almunajib/mcu-vm/Top-Layer_MCU4.5.jpg

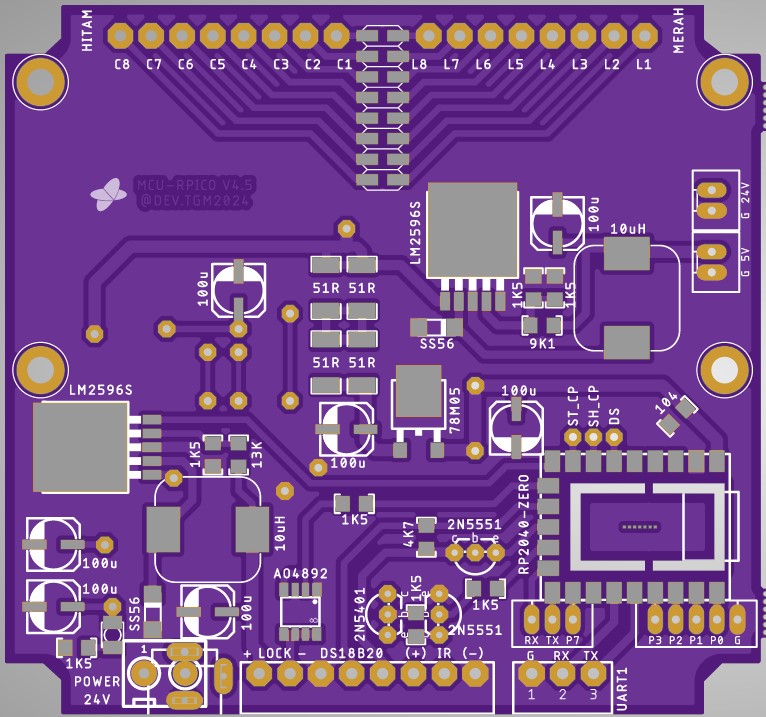
Top-Layer_MCU4.5.jpg
