almunajib/mcu-vm/SS-SerialSender.png

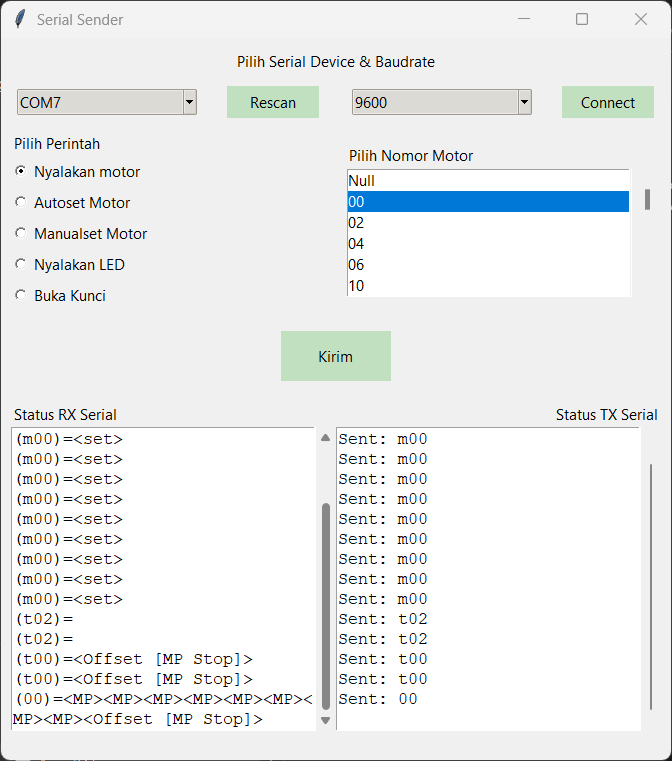
SS-SerialSender.png
