almunajib/mcu-vm/Daftar-komponen_MCU4.5-combined.xlsx

Qty | Value | Device | Parts | Harga | Total | STOK BARANG | LINK
1 |  | JACK-DC_5.5X2.5MM MALE | J3 | Rp 1200 | Rp 1200 | READY | https://www.tokopedia.com/rajacell/dc-005-socket-female-jack-dc-power-jack-5-5mm-x-2-1mm-3p-tanampcb-hitam
1 |  | JACK-DC_5.5X2.5MM FEMALE |  | Rp 1700 |  | READY | https://www.tokopedia.com/rajacell/jack-dc-5-5mm-x-2-1mm-yellow-head-dengan-kabel-20cm-kabel-merah
64 |  | LED2835 | B1, B2, B3, B4, B5, B6, B7, B8, B9, B10, B11, B12, B13, B14, B15, B16, B17, B18, B19, B20, B21, B22, B23, B24, B25, B26, B27, B28, B29, B30, B31, B32, B33, B34, B35, B36, B37, B38, B39, B40, B41, B42, B43, B44, B45, B46, B47, B48, B49, B50, B51, B52, B53, B54, B55, B56, B57, B58, B59, B60, B61, B62, B63, B64 | Rp 100 | Rp 6400 | READY MIN.ORDER 50 PCS | https://www.tokopedia.com/mirorim/smd-led-chip-2835-0-2w-cool-cold-warm-white-putih-kuning-lampu-strip-warm-white
1 | POWER | LED2835 | D2 | Rp 100 | Rp 100 | READY | https://www.tokopedia.com/mirorim/smd-led-chip-2835-0-2w-cool-cold-warm-white-putih-kuning-lampu-strip-warm-white
1 |  | PINHEAD_2X8PTH | J4 | Rp 3250 | Rp 3250 | READY | https://www.tokopedia.com/rajacell/double-row-female-header-2x40-pin-socket-female-pitch-254mm-double
1 |  | PINHEAD_2X8SMT | J5 | Rp 5500 | Rp 5500 | READY | https://www.tokopedia.com/rajacell/2x40p-smd-male-header-smt-pitch-2-54mm-double-row-straight-male-gold-plated-2-40-80-pin
2 |  | SOKET-2P_JST-XH-2.54 | X7, X8 | Rp 350 | Rp 700 | READY | https://www.tokopedia.com/easyware-id/set-jst-xh-connector-2p-lurus-header-2-pin-male-female-xh-2-54mm-female-d0c8c
1 |  | SOKET-3P_JST-XH-2.54 | J1 | Rp 400 | Rp 400 | READY | https://www.tokopedia.com/easyware-id/connector-jst-xh2-54-3p-male-straight-header-2-54mm-ci22-3-pin-female-female
1 |  | SOKET-5P_JST-XH-2.54 | X3 | Rp 500 | Rp 500 | READY | https://www.tokopedia.com/easyware-id/connector-jst-xh2-54-5p-male-straight-header-2-54mm-ci22-5-pin-female-female
12 |  |  |  | Rp 110 | Rp 1320 | READY MIN.ORDER 10 PCS | https://www.tokopedia.com/easyware-id/jst-xh2-50mm-ci22-inner-2-50-mm-female-wire-housing-pin-metal-terminal
1 |  | TBLOCK-2P_5.08MM | XDC | Rp 2250 | Rp 2250 | KOSONG | https://www.tokopedia.com/marnov/15edgk-r-3-81-2p-screw-siku-15edgk-terminal-3-81mm-mm-2-pin-2edg
1 |  | TBLOCK-3P_KF2EDG-3.81 | J6 | Rp 2750 | Rp 2750 |  | https://www.tokopedia.com/marnov/15edgk-r-3-81-3p-screw-siku-15edgk-terminal-3-81mm-mm-3-pin-2edg
1 |  | TBLOCK-8P_KF2EDG-3.81 | X1 | Rp 7000 | Rp 7000 |  | https://www.tokopedia.com/marnov/15edgk-r-3-81-8p-screw-siku-15edgk-terminal-3-81mm-mm-8-pin-2edg
7 | 100u | ELCO_UD-6,3X7,7 | C1, C3, C4, C5, C6, C7, C11 | Rp 800 | Rp 5600 |  | https://www.tokopedia.com/jogjarobotika/25v-100uf-smd-elco-6-7mm
4 | 104 | CAP_SMD-C1206 | C8, C9, C10, C14 | Rp 250 | Rp 1000 | READY MIN.ORDER 25 PCS | https://www.tokopedia.com/lisuinstrument/100nf-10-50v-x7r-1206-3216-mm-smd-ceramic-capacitor-fn31x104k500pxg
24 | 10K | RESISTOR_1206 | R6, R7, R8, R10, R11, R13, R14, R15, R17, R20, R21, R22, R25, R26, R27, R30, R31, R32, R35, R36, R37, R38, R41, R42 | Rp 100 | Rp 2400 | READY | https://www.tokopedia.com/jogjarobotika/10k-ohm-smd-1206-resistor
2 | 10uH | INDUKTORSMD | L1, L2 | Rp 1000 | Rp 2000 | READY | https://www.tokopedia.com/tokopuwei/power-inductor-10uh-smd-5a-cd127-smt-induktor-12-x-12-x-7mm-ak00
1 | 13K | RESISTOR_1206 | R2 | Rp 100 | Rp 100 | READY MIN.ORDER 25 PCS | https://www.tokopedia.com/lisuinstrument/13k-1206-3216-mm-1-thick-film-smd-resistor-250mw-13k
10 | 1K5 | RESISTOR_1206 | R4, R5, R12, R18, R28, R39, R45, R46, R47, R49 | Rp 100 | Rp 1000 | READY MIN.ORDER 10 PCS | https://www.tokopedia.com/lisuinstrument/1-5k-1206-1-thick-film-resistors-smd-chip-resistor-1501-1k5
1 | 2N5401 | BJT-PNP_TO92-EBC | Q10 | Rp 150 | Rp 150 | READY | https://www.tokopedia.com/lisuinstrument/2n5401-pnp-bipolar-transistor-bjt-to-92-generic-biasa-88350
2 | 2N5551 | BJT-NPN_TO92-EBC | TR10, TR12 | Rp 150 | Rp 300 | READY | https://www.tokopedia.com/lisuinstrument/2n5551-npn-bipolar-transistor-bjt-to-92-generic-biasa-a4086
8 | 2x1K5 GANTI 470 | RESISTOR_1206 | R3, R16, R19, R23, R24, R29, R33, R34 | Rp 250 | Rp 2000 | READY MIN.ORDER 10 PCS | https://www.tokopedia.com/lisuinstrument/470r-1210-3225-metric-1-thick-film-resistor-smd-470-0-5w
1 | 4K7 | RESISTOR_1206 | R9 | Rp 250 | Rp 250 | READY MIN.ORDER 10 PCS | https://www.tokopedia.com/lisuinstrument/4-7k-1210-3225-1-thick-film-resistor-smd-4-7k-100ppm-c-0-5w
6 | 51R | RESISTOR_2512 | R1, R40, R44, R48, R50, R51 | Rp 500 | Rp 3000 | READY MIN.ORDER 11 PCS | https://www.tokopedia.com/lisuinstrument/51r-2512-5-1w-thick-film-resistor-smd-chip-resistor-510-51r
2 | 74595 | 74595 | IC1, IC2 | Rp 620 | Rp 1240 | READY | https://www.tokopedia.com/tokopuwei/ic-74hc595-74hc595d-smd-sop-16-shift-register-chip-au08
1 | 78M05 | 78XXX_TO252 | IC4 | Rp 600 | Rp 600 | READY | https://www.tokopedia.com/tokopuwei/smd-7805-regulator-78m05-5v-smd-regulator-to252-dpack-d-pack-af73
1 | 9K1 | RESISTOR_1206 | R43 | Rp 100 | Rp 100 | READY | https://www.tokopedia.com/jogjarobotika/9k1-ohm-smd-1206-resistor
1 | AMS1117 | 78XXX_SOT223 | VREG2 | Rp 700 | Rp 700 | READY | https://www.tokopedia.com/tokopuwei/ams1117-33v-33v-1a-smd-voltage-regulator-sot223-3v3-sot-223-ah33
5 | AO4892 | DUALFET-N_AO4892N+N | Q5, Q6, Q7, Q8, Q9 | Rp 9500 | Rp 47500 | READY | https://www.tokopedia.com/lisuinstrument/ao4892-4892-100v-4a-dual-n-channel-mosfet-alpha-omega-original
4 | APM4953 | DUALFET-P_NCE4953P+P | Q1, Q2, Q3, Q4 | Rp 2500 | Rp 10000 | READY | https://www.tokopedia.com/jogjarobotika/4953-apm4953-sop8-dual-p-channel-mosfet
1 | HITAM | TBLOCK-8P_KF2EDG-3.81 | J8 | Rp 7000 | Rp 7000 | READY | https://www.tokopedia.com/marnov/15edgk-r-3-81-8p-screw-siku-15edgk-terminal-3-81mm-mm-8-pin-2edg
2 | LM2596S | LM2596S | IC5, IC6 | Rp 4500 | Rp 9000 | READY | https://www.tokopedia.com/permony/ic-lm2596hvs-3a-adjustable-lm2596-lm2596s
1 | MERAH | TBLOCK-8P_KF2EDG-3.81 | J2 | Rp 7000 | Rp 7000 | READY | https://www.tokopedia.com/marnov/15edgk-r-3-81-8p-screw-siku-15edgk-terminal-3-81mm-mm-8-pin-2edg
1 | RP2040-ZERO | RASPBERRY-PICO-ZERO-SMT_TYPE-C | U2 | Rp 60000 | Rp 60000 | READY | https://www.tokopedia.com/hobielektronika/raspberry-pi-pico-rp2040-zero-mikrocontroller-dual-core-cortex-m0
2 | SS56 GANTI SS36A | DIODE_DO214AC | D3, D5 | Rp 800 | Rp 1600 | READY MIN.ORDER 5 PCS | https://www.tokopedia.com/lisuinstrument/ss36a-60v-3a-schottky-diode-sma-do-214ac-ss36-hottech-original
1 | SS56C GANTI SS510 | DIODE_DO214AB-SMC | D1 | Rp 1600 | Rp 1600 | READY MIN.ORDER 6 PCS | https://www.tokopedia.com/lisuinstrument/ss510c-5a-100v-schottky-barrier-diode-ss510-do-214ab-smc-jingdao
1 | ULN2803 | ULN2805ASO18 | IC3 | Rp 2750 | Rp 2750 | READY | https://www.tokopedia.com/rajacell/ic-uln2803-uln2803ag-smd-sop-18-8channel-darlington-sink-driver
1 |  | Box PLC |  | Rp 25000 | Rp 25000 | READY | https://www.tokopedia.com/sinarled/box-plc-115-90-40
1 |  | rivet lubang 0.9 mm |  | Rp 15000 | Rp 15000 | READY | https://www.tokopedia.com/gresstudio/0-9x3mm-0-9mm-tubular-rivets-round-head-copper-brass-hollow-rivets
 |  |  |  |  | Rp 238260
