almunajib/mcu-vm/MAINBOARD VM-MCU v4.5/VM-MCU_v4.5.brd

## EAGLE design MAINBOARD VM-MCU v4.5/VM-MCU_v4.5.brd (2025-02-11)

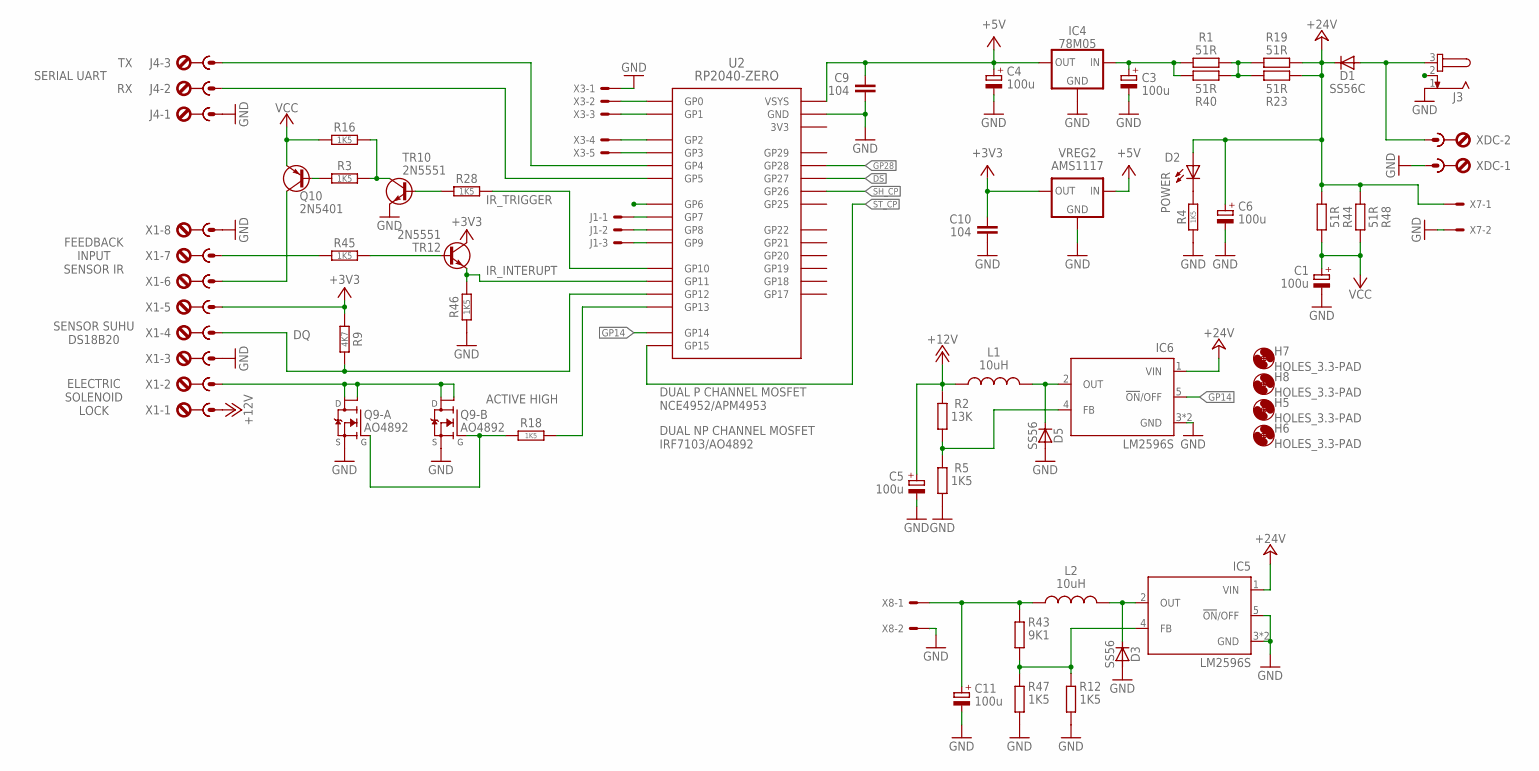
[picture p3: schematic VM-MCU_v4.5.sch, sheet 1]

Parts:
C1, C3, C4, C5, C6, C11: 100u; UD-6,3X7,7_NICHICON
C9, C10: 104; C1206
D1: SS56C; DO214AB
D2: POWER; LED2835
D3, D5: SS56; DO214AC
H5, H6, H7, H8: HOLES_3.3-PAD; 3,3-PAD
IC4: 78M05; TO252
IC5, IC6: LM2596S; TO263-5
J1: SOKET-3P_JST-XH-2.54; 3P-JST-XH
J3: JACK-DC_5.5X2.5MM; DC-5.5X2.5
J4: TBLOCK-3P_KF2EDG-3.81; KF2EDG-3.81_3P
L1, L2: 10uH; CDRH127/LD
Q9: AO4892; SO-8
Q10: 2N5401; TO92-EBC
R1, R19, R23, R40, R44, R48: 51R; R2512
R2: 13K; R1206
R3, R4, R5, R12, R16, R18, R28, R45, R46, R47: 1K5; R1206
R9: 4K7; R1206
R43: 9K1; R1206
TR10, TR12: 2N5551; TO92-EBC
U2: RP2040-ZERO; PICO-ZERO-SMT-C
VREG2: AMS1117; SOT223
X1: TBLOCK-8P_KF2EDG-3.81; KF2EDG-3.81_8P
X3: SOKET-5P_JST-XH-2.54; 5P-JST-XH
X7, X8: SOKET-2P_JST-XH-2.54; 2P-JST-XH
XDC: TBLOCK-2P_5.08MM; KF128-5_2P

Connections:
3V3: U2.3V3
+3V3: C10.1, R9.1, TR12.C, VREG2.4 (OUT), X1.5
+5V: C4.+, C9.1, IC4.2 (OUT), U2.5V (VSYS), VREG2.3 (IN); also elsewhere on the board
+12V: C5.+, L1.1, R2.1, X1.1
+24V: C6.+, D1.C, D2.A, IC5.1 (VIN), IC6.1 (VIN), R19.2, R23.1, R44.1, R48.1, X7.1; also elsewhere on the board
DS: U2.P27 (GP27); also elsewhere on the board
GND: C1.-, C3.-, C4.-, C5.-, C6.-, C9.2, C10.2, C11.-, D3.A, D5.A, IC4.3 (GND), IC5.3 (GND), IC5.5 (!ON!/OFF), IC5.6 (GND), IC6.3 (GND), IC6.6 (GND), J3.1, J4.1, Q9.1 (S), Q9.3 (S), R4.1, R5.2, R12.2, R46.1, R47.2, TR10.E, U2.G (GND), VREG2.1 (GND), X1.3, X1.8, X3.1, X7.2, X8.2, XDC.1; also elsewhere on the board
GP7: J1.1, U2.P7 (GP7)
GP8_TX: J1.2, U2.P8 (GP8)
GP9_RX: J1.3, U2.P9 (GP9)
GP12: R9.2, U2.P12 (GP12), X1.4
GP14: IC6.5 (!ON!/OFF), U2.P14 (GP14)
GP28: U2.P28 (GP28)
unnamed: J4.3, U2.P4 (GP4)
unnamed: J4.2, U2.P5 (GP5)
unnamed: D1.A, J3.3, XDC.2
unnamed: D2.C, R4.2
unnamed: C3.+, IC4.1 (IN), R1.1, R40.2
unnamed: R3.2, R16.2, TR10.C
unnamed: Q10.B, R3.1
unnamed: R1.2, R19.1, R23.2, R40.1
unnamed: U2.P1 (GP1), X3.3
unnamed: Q10.E, X1.6
unnamed: U2.P0 (GP0), X3.2
unnamed: Q9.2 (G), Q9.4 (G), R18.2
unnamed: D3.C, IC5.2 (OUT), L2.2
unnamed: U2.P2 (GP2), X3.4
unnamed: U2.P3 (GP3), X3.5
unnamed: C11.+, L2.1, R43.1, X8.1
unnamed: Q9.5 (D1), Q9.6 (D2), Q9.7 (D2), Q9.8 (D1), X1.2
unnamed: D5.C, IC6.2 (OUT), L1.2
unnamed: IC6.4 (FB), R2.2, R5.1
unnamed: IC5.4 (FB), R12.1, R43.2, R47.1
unnamed: R28.1, TR10.B
unnamed: R45.1, TR12.B
unnamed: R45.2, X1.7
P10: R28.2, U2.P10 (GP10)
P11: R46.2, TR12.E, U2.P11 (GP11)
P13: R18.1, U2.P13 (GP13)
SH_CP: U2.P26 (GP26); also elsewhere on the board
ST_CP: U2.P15 (GP15); also elsewhere on the board
VCC: C1.+, Q10.C, R16.1, R44.2, R48.2

Notes on the sheet:
SENSOR SUHU DS18B20
FEEDBACK INPUT SENSOR IR
ELECTRIC SOLENOID LOCK
IR_TRIGGER
ACTIVE HIGH
IR_INTERUPT
SERIAL UART
DUAL P CHANNEL MOSFET NCE4952/APM4953
DUAL NP CHANNEL MOSFET IRF7103/AO4892

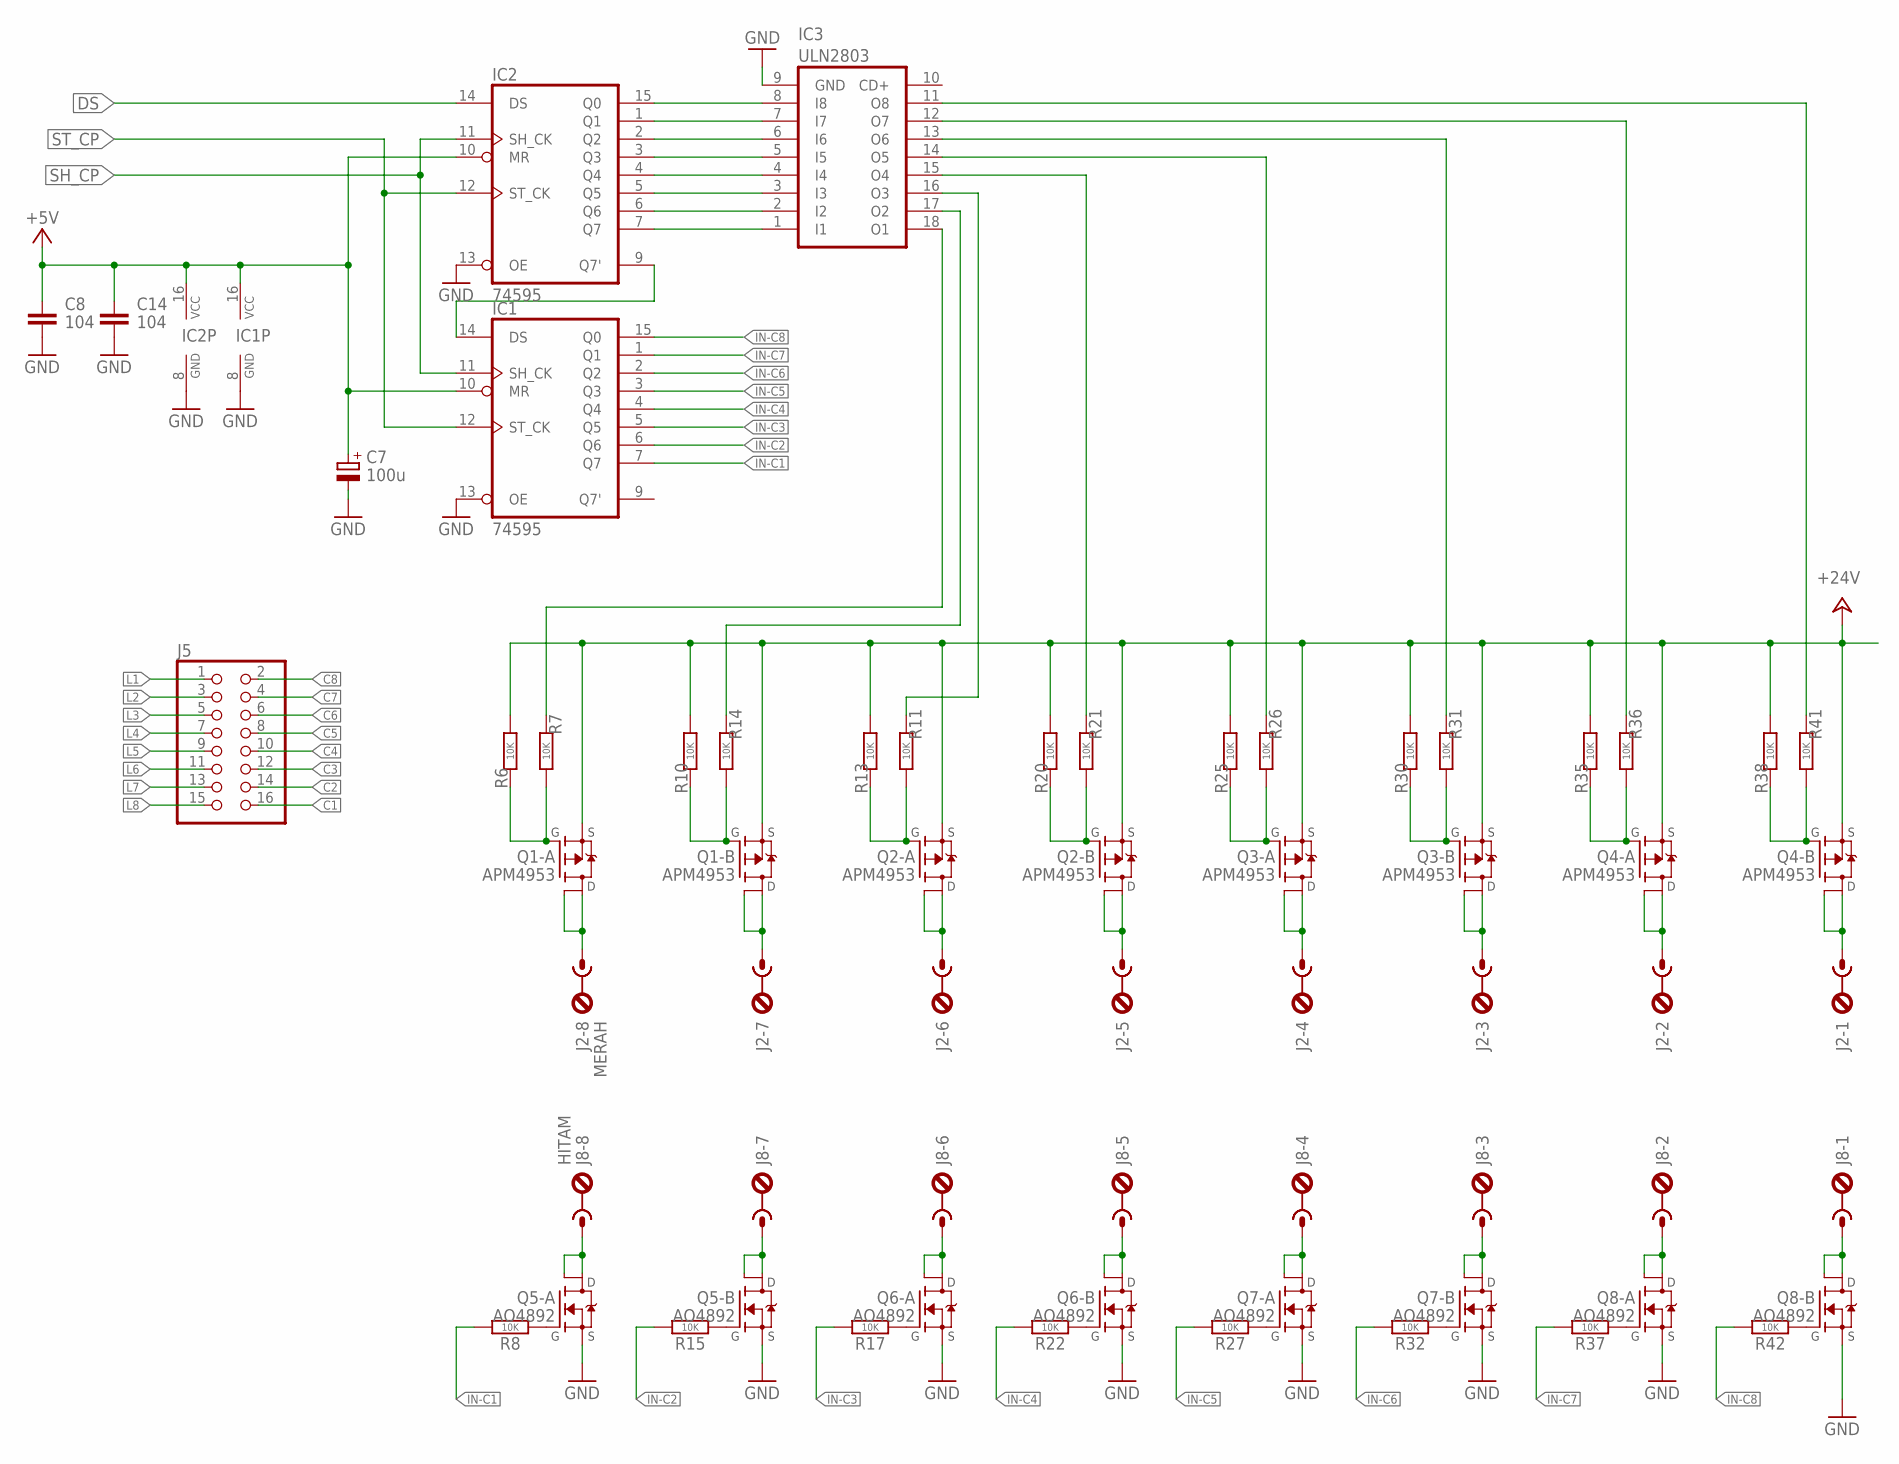
[picture p4: schematic VM-MCU_v4.5.sch, sheet 2]

Parts:
C7: 100u; UD-6,3X7,7_NICHICON
C8, C14: 104; C1206
IC1, IC2: 74595; SO16
IC3: ULN2803; SO18W
J2: MERAH; KF2EDG-3.81_8P
J5: PINHEAD_2X8SMT; PINHEAD-SMT_2X08
J8: HITAM; KF2EDG-3.81_8P
Q1, Q2, Q3, Q4: APM4953; SO-8
Q5, Q6, Q7, Q8: AO4892; SO-8
R6, R7, R8, R10, R11, R13, R14, R15, R17, R20, R21, R22, R25, R26, R27, R30, R31, R32, R35, R36, R37, R38, R41, R42: 10K; R1206

Connections:
+5V: C7.+, C8.1, C14.1, IC1.10 (MR), IC1.16 (VCC), IC2.10 (MR), IC2.16 (VCC); also elsewhere on the board
+24V: Q1.1 (S), Q1.3 (S), Q2.1 (S), Q2.3 (S), Q3.1 (S), Q3.3 (S), Q4.1 (S), Q4.3 (S), R6.1, R10.1, R13.1, R20.1, R25.1, R30.1, R35.1, R38.1; also elsewhere on the board
C1: J5.16, J8.8, Q5.7 (D2), Q5.8 (D1)
C2: J5.14, J8.7, Q5.5 (D1), Q5.6 (D2)
C3: J5.12, J8.6, Q6.7 (D2), Q6.8 (D1)
C4: J5.10, J8.5, Q6.5 (D1), Q6.6 (D2)
C5: J5.8, J8.4, Q7.7 (D2), Q7.8 (D1)
C6: J5.6, J8.3, Q7.5 (D1), Q7.6 (D2)
C7: J5.4, J8.2, Q8.7 (D2), Q8.8 (D1)
C8: J5.2, J8.1, Q8.5 (D1), Q8.6 (D2)
DS: IC2.14 (DS); also elsewhere on the board
GND: C7.-, C8.2, C14.2, IC1.8 (GND), IC1.13 (OE), IC2.8 (GND), IC2.13 (OE), IC3.9 (GND), Q5.1 (S), Q5.3 (S), Q6.1 (S), Q6.3 (S), Q7.1 (S), Q7.3 (S), Q8.1 (S), Q8.3 (S); also elsewhere on the board
IN-C1: IC1.7 (Q7), R8.2
IN-C2: IC1.6 (Q6), R15.2
IN-C3: IC1.5 (Q5), R17.2
IN-C4: IC1.4 (Q4), R22.2
IN-C5: IC1.3 (Q3), R27.2
IN-C6: IC1.2 (Q2), R32.2
IN-C7: IC1.1 (Q1), R37.2
IN-C8: IC1.15 (Q0), R42.2
L1: J2.8, J5.1, Q1.7 (D2), Q1.8 (D1)
L2: J2.7, J5.3, Q1.5 (D1), Q1.6 (D2)
L3: J2.6, J5.5, Q2.7 (D2), Q2.8 (D1)
L4: J2.5, J5.7, Q2.5 (D1), Q2.6 (D2)
L5: J2.4, J5.9, Q3.7 (D2), Q3.8 (D1)
L6: J2.3, J5.11, Q3.5 (D1), Q3.6 (D2)
L7: J2.2, J5.13, Q4.7 (D2), Q4.8 (D1)
L8: J2.1, J5.15, Q4.5 (D1), Q4.6 (D2)
unnamed: IC2.15 (Q0), IC3.8 (I8)
unnamed: IC2.1 (Q1), IC3.7 (I7)
unnamed: Q1.2 (G), R6.2, R7.1
unnamed: IC3.17 (O2), R14.2
unnamed: Q5.2 (G), R8.1
unnamed: Q1.4 (G), R10.2, R14.1
unnamed: IC2.2 (Q2), IC3.6 (I6)
unnamed: Q2.2 (G), R11.1, R13.2
unnamed: IC2.3 (Q3), IC3.5 (I5)
unnamed: Q5.4 (G), R15.1
unnamed: IC2.4 (Q4), IC3.4 (I4)
unnamed: IC3.18 (O1), R7.2
unnamed: Q2.4 (G), R20.2, R21.1
unnamed: Q6.2 (G), R17.1
unnamed: IC2.5 (Q5), IC3.3 (I3)
unnamed: IC2.6 (Q6), IC3.2 (I2)
unnamed: IC2.7 (Q7), IC3.1 (I1)
unnamed: IC3.16 (O3), R11.2
unnamed: IC3.15 (O4), R21.2
unnamed: Q3.2 (G), R25.2, R26.1
unnamed: Q6.4 (G), R22.1
unnamed: IC3.14 (O5), R26.2
unnamed: Q3.4 (G), R30.2, R31.1
unnamed: Q7.2 (G), R27.1
unnamed: IC3.13 (O6), R31.2
unnamed: Q4.2 (G), R35.2, R36.1
unnamed: Q7.4 (G), R32.1
unnamed: IC3.12 (O7), R36.2
unnamed: Q4.4 (G), R38.2, R41.1
unnamed: Q8.2 (G), R37.1
unnamed: IC3.11 (O8), R41.2
unnamed: Q8.4 (G), R42.1
unnamed: IC1.14 (DS), IC2.9 (Q7')
SH_CP: IC1.11 (SH_CK), IC2.11 (SH_CK); also elsewhere on the board
ST_CP: IC1.12 (ST_CK), IC2.12 (ST_CK); also elsewhere on the board

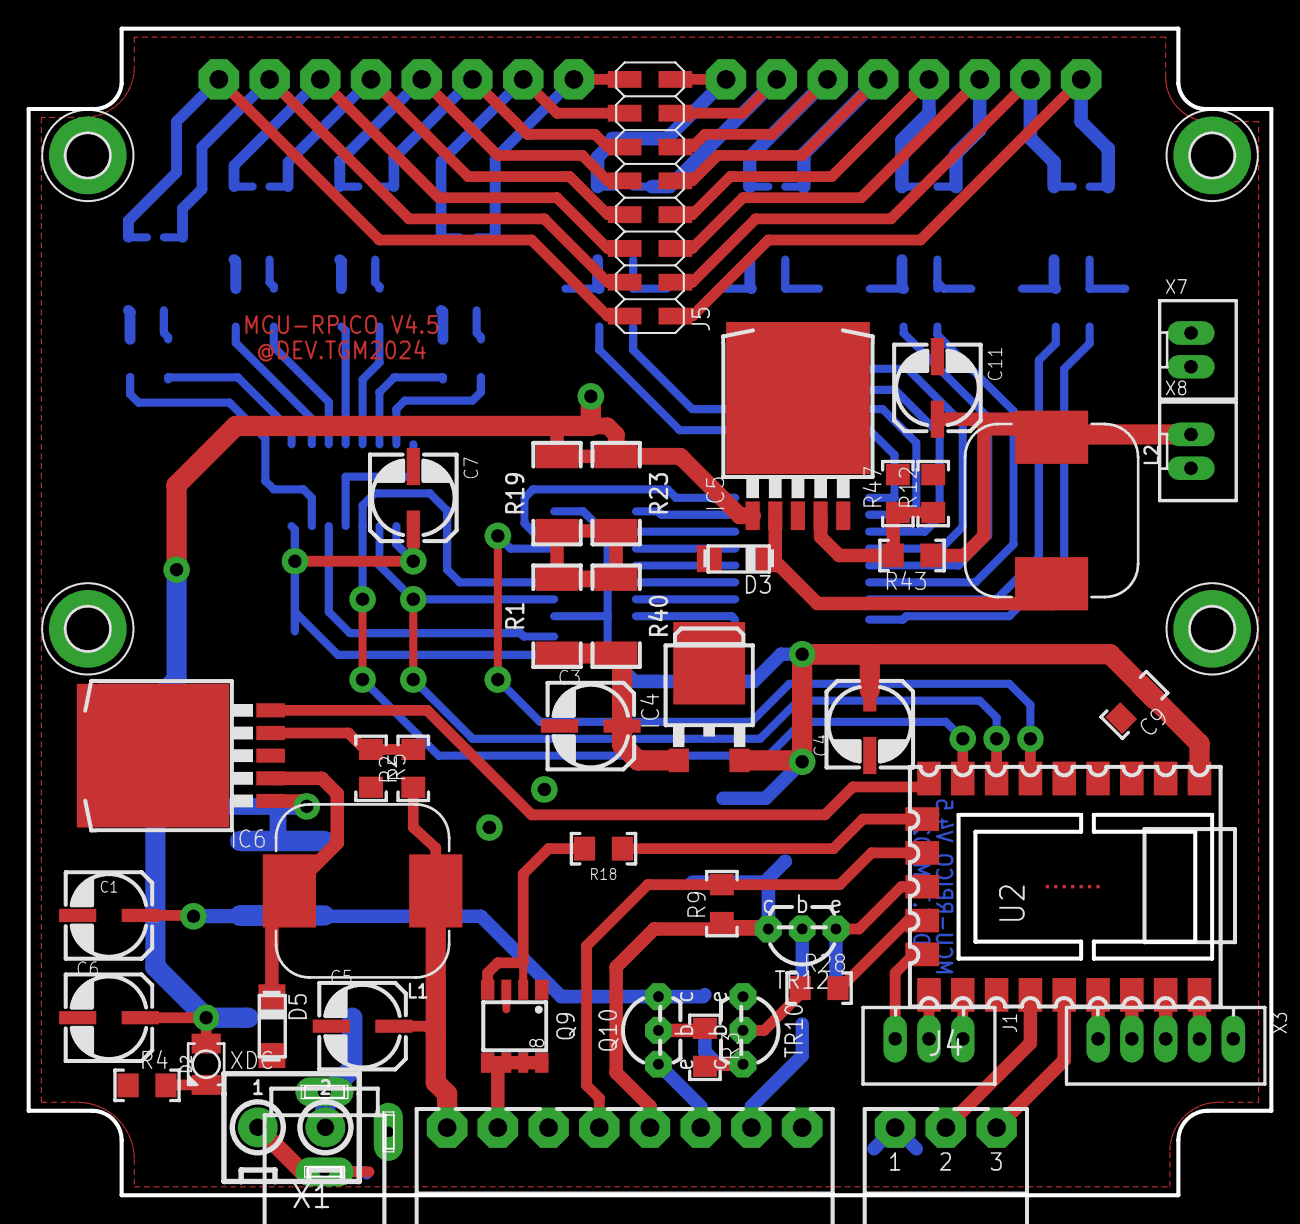
[picture p5: board VM-MCU_v4.5.brd from above]

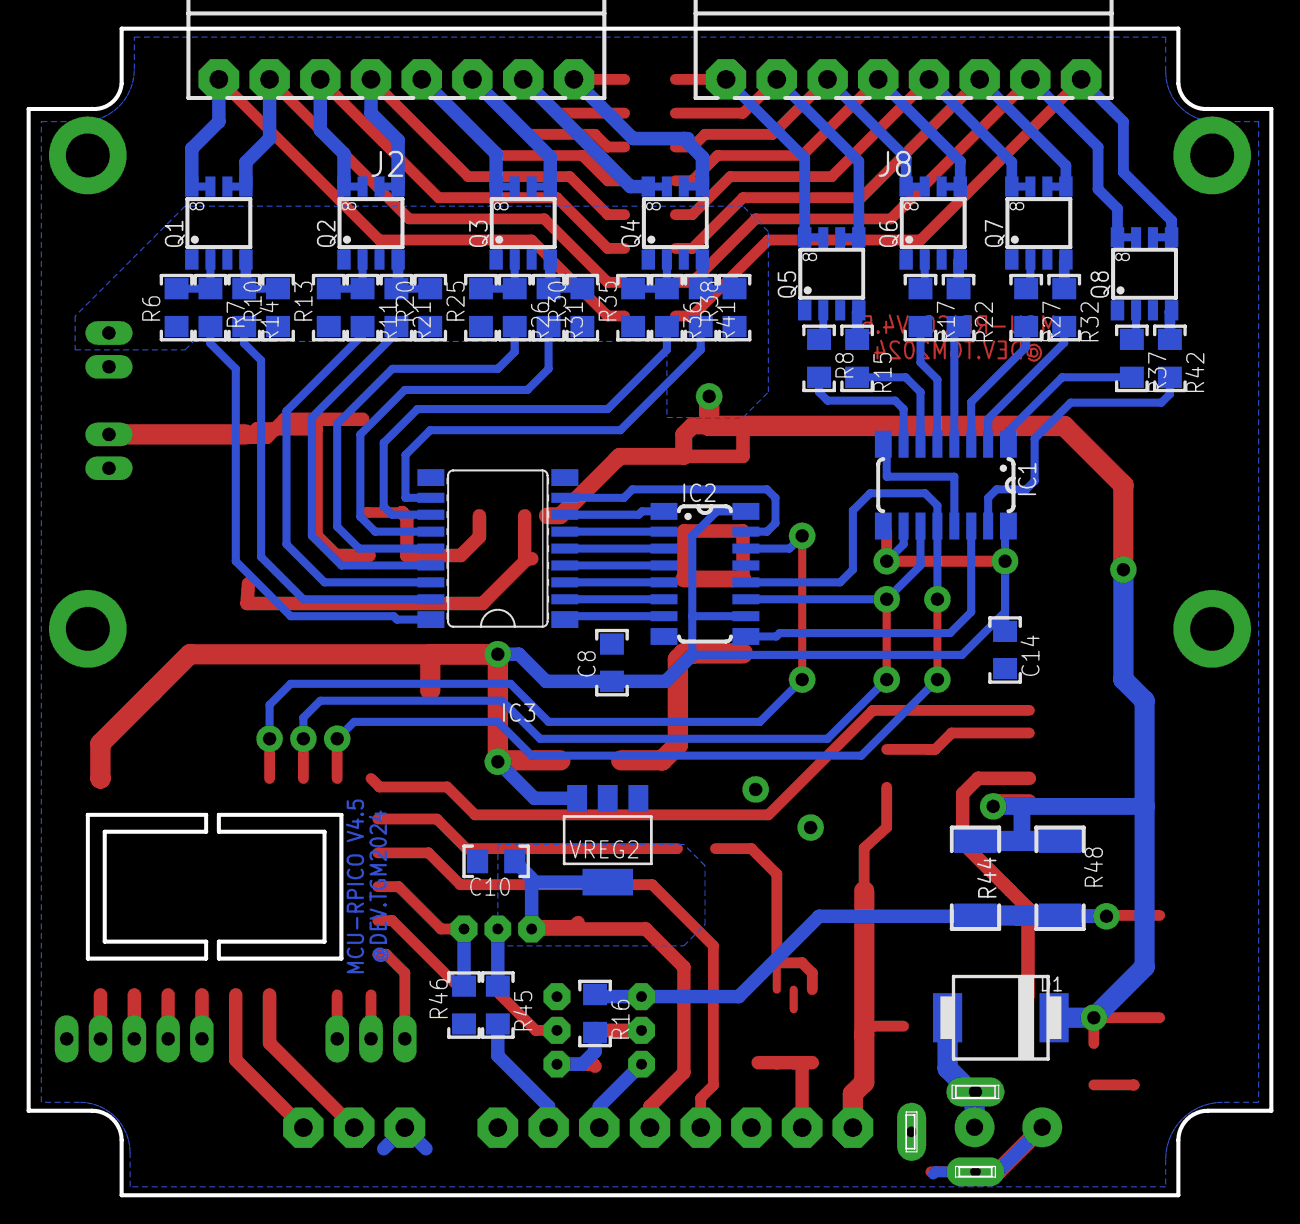
[picture p6: board VM-MCU_v4.5.brd from below]

Board: 2 copper layers, 93.3 x 87.6 mm, 96 parts (47 on the bottom side), 97 nets.

Other parts of the board:
U$1: BOX-PLC_115X90
