almunajib/mcu-vm/8x8 MotorState Display/8x8-MotorState.brd

## EAGLE design 8x8 MotorState Display/8x8-MotorState.brd (2025-02-11)

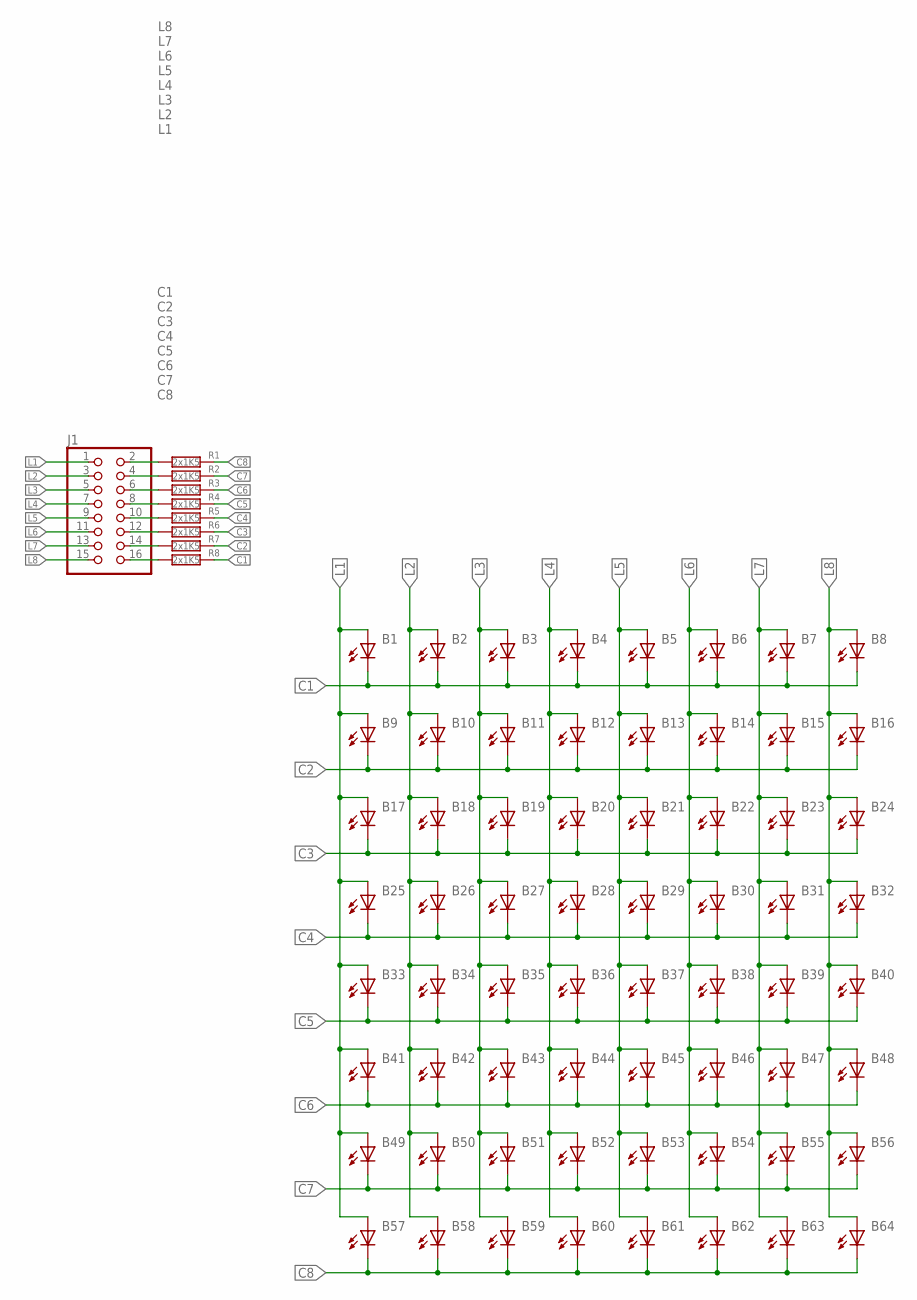
[picture p7: schematic 8x8-MotorState.sch]

Parts:
B1, B2, B3, B4, B5, B6, B7, B8, B9, B10, B11, B12, B13, B14, B15, B16, B17, B18, B19, B20, B21, B22, B23, B24, B25, B26, B27, B28, B29, B30, B31, B32, B33, B34, B35, B36, B37, B38, B39, B40, B41, B42, B43, B44, B45, B46, B47, B48, B49, B50, B51, B52, B53, B54, B55, B56, B57, B58, B59, B60, B61, B62, B63, B64: LED2835
J1: PINHEAD_2X8PTH; PINHEAD-2X08
R1, R2, R3, R4, R5, R6, R7, R8: 2x1K5; R1206

Connections:
C1: B1.C, B2.C, B3.C, B4.C, B5.C, B6.C, B7.C, B8.C, R8.1
C2: B9.C, B10.C, B11.C, B12.C, B13.C, B14.C, B15.C, B16.C, R7.1
C3: B17.C, B18.C, B19.C, B20.C, B21.C, B22.C, B23.C, B24.C, R6.1
C4: B25.C, B26.C, B27.C, B28.C, B29.C, B30.C, B31.C, B32.C, R5.1
C5: B33.C, B34.C, B35.C, B36.C, B37.C, B38.C, B39.C, B40.C, R4.1
C6: B41.C, B42.C, B43.C, B44.C, B45.C, B46.C, B47.C, B48.C, R3.1
C7: B49.C, B50.C, B51.C, B52.C, B53.C, B54.C, B55.C, B56.C, R2.1
C8: B57.C, B58.C, B59.C, B60.C, B61.C, B62.C, B63.C, B64.C, R1.1
L1: B1.A, B9.A, B17.A, B25.A, B33.A, B41.A, B49.A, B57.A, J1.1
L2: B2.A, B10.A, B18.A, B26.A, B34.A, B42.A, B50.A, B58.A, J1.3
L3: B3.A, B11.A, B19.A, B27.A, B35.A, B43.A, B51.A, B59.A, J1.5
L4: B4.A, B12.A, B20.A, B28.A, B36.A, B44.A, B52.A, B60.A, J1.7
L5: B5.A, B13.A, B21.A, B29.A, B37.A, B45.A, B53.A, B61.A, J1.9
L6: B6.A, B14.A, B22.A, B30.A, B38.A, B46.A, B54.A, B62.A, J1.11
L7: B7.A, B15.A, B23.A, B31.A, B39.A, B47.A, B55.A, B63.A, J1.13
L8: B8.A, B16.A, B24.A, B32.A, B40.A, B48.A, B56.A, B64.A, J1.15
unnamed: J1.2, R1.2
unnamed: J1.4, R2.2
unnamed: J1.6, R3.2
unnamed: J1.8, R4.2
unnamed: J1.10, R5.2
unnamed: J1.12, R6.2
unnamed: J1.14, R7.2
unnamed: J1.16, R8.2

Notes on the sheet:
C1 C2 C3 C4 C5 C6 C7 C8
L8 L7 L6 L5 L4 L3 L2 L1

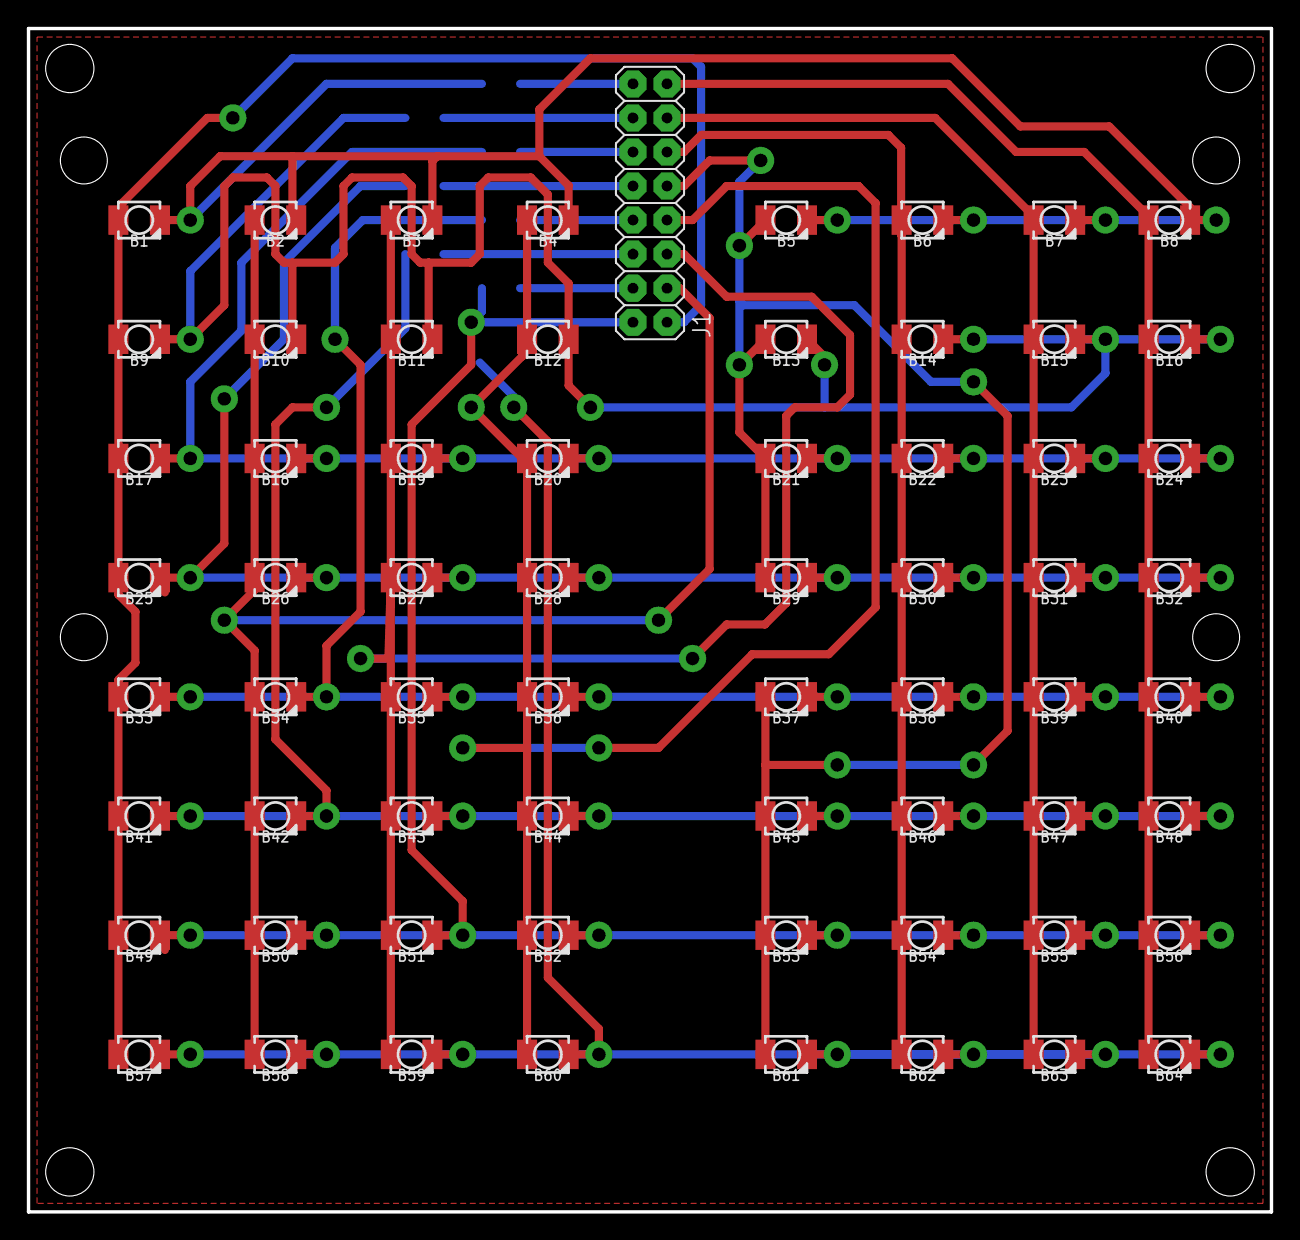
[picture p8: board 8x8-MotorState.brd from above]

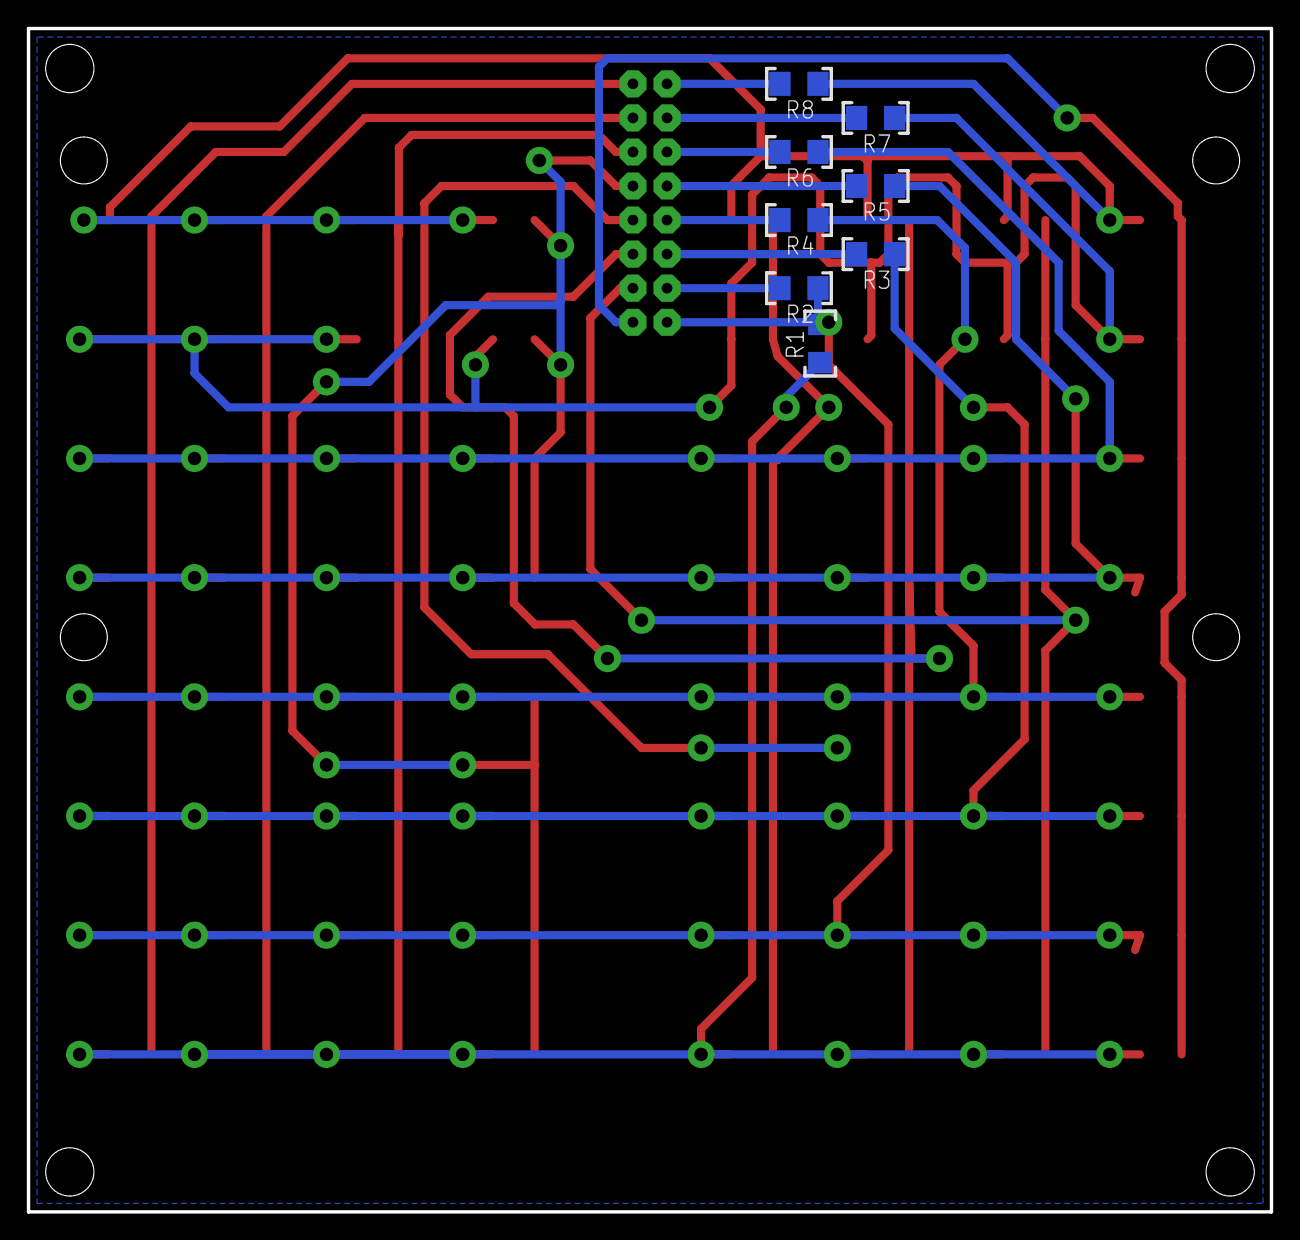
[picture p9: board 8x8-MotorState.brd from below]

Board: 2 copper layers, 92.7 x 88.3 mm, 74 parts (8 on the bottom side), 24 nets.

Other parts of the board:
U$1: BOX-PLC_115X90_V2
