almunajib/mcu-vm/(commit log)

2025-02-11 file mainboard eagle
    [8x8-MotorState.brd, 8x8-MotorState.sch, Daftar-komponen_MCU4.5-combined.xlsx, VM-MCU_v4.5.brd, VM-MCU_v4.5.sch]
2025-02-11 Add files via upload
    main code for RPico2040 to control 8x8 Axis Motor
    Firmware for RPico2040 zero
2025-02-21 Tampilan Utama Serial Sender
    text di dalam kurung ( ) merupakan baris input perintah serial
    text di dalam tanda <> merupakan baris action dari mikrokontroller
    text di dalam tanda [ ] merupakan baris interupt yang mikrokontroller deteksi dari sensor IR ataupun trigger posisi dari limit switch pada Offset Motor
